AhmedBU21EECE0200026/Capstone-Project-EEE-2025-Empowering-Smart-Grid-for-the-future-of-Urban-Centers/Capstione Project Final/Hardware/Smart Grid/IMG-20250316-WA0008.jpg

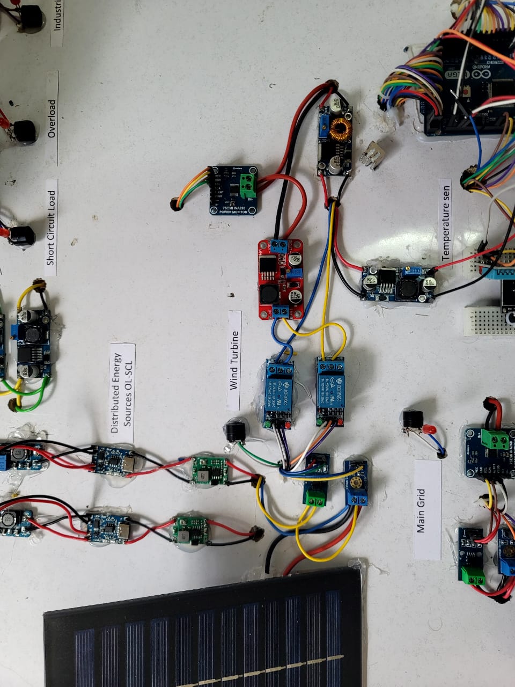
Capstione Project Final/Hardware/Smart Grid/IMG-20250316-WA0008.jpg
