AhmedBU21EECE0200026/Capstone-Project-EEE-2025-Empowering-Smart-Grid-for-the-future-of-Urban-Centers/Capstone Project Introduction/Capston Project poster.pptx

Empowering Smart Grid For The Future Of Urban Centres

Ahmed Abdulrahman Abdullah Bin Alfaqeeh – Seepala Siva Kumar – Yashwanth M

Supervisor : <<Dr. P Sundararaman >>

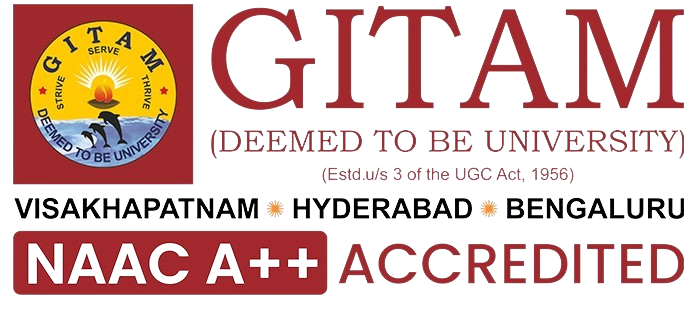
[picture p3: figure]

Abstract

Conclusion

Methods

Results

Background

Future Perspectives

In this project, we successfully designed and integrated a hybrid energy system that includes a solar farm, wind farm, diesel generator, and battery storage system. The solar farm operates based on solar irradiance and temperature data, while the wind farm functions using wind speed data. These energy sources were connected to different types of loads (resistive, capacitive, and inductive), and circuit breakers were incorporated for system protection and control. The project demonstrates efficient energy management by combining renewable sources with a backup generator, ensuring a stable power supply.

In the future, IoT devices will be integrated into the system for enhanced real-time monitoring and remote control. This will enable better supervision, data collection, and optimization of the system's overall performance. The next phase will focus on improving the automation and reliability of the hybrid energy system for real-world applications in urban centers.

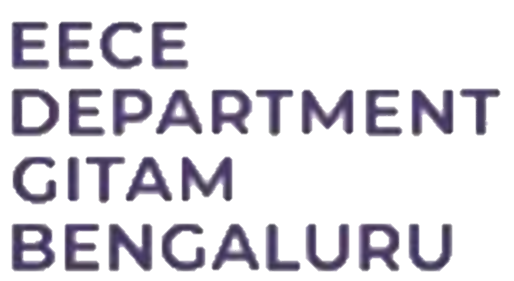
[picture p4: figure]
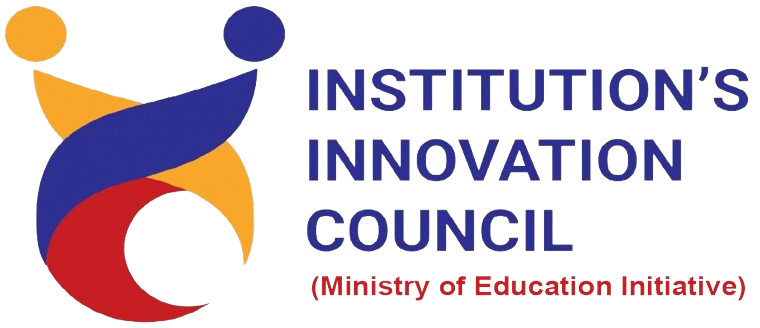
[picture p5: figure]
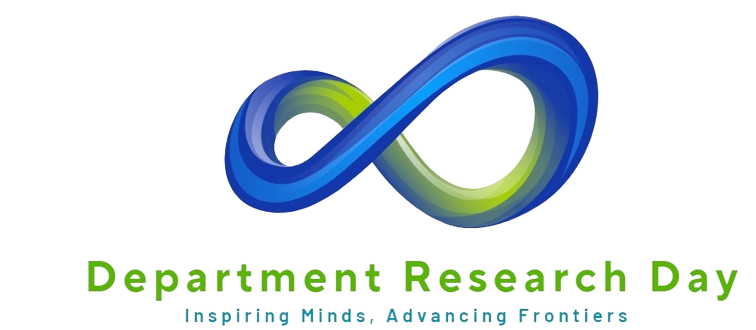
[picture p6: figure]

Insert your text Here

As urban centres continue to grow, the demand for reliable and sustainable energy sources becomes increasingly critical. Our project, "Empowering Smart Grid for the Future of Urban Centres," aims to design and simulate an advanced smart grid system that integrates renewable energy sources—specifically solar and wind power—along with Internet of Things (IoT) devices. The integration of these renewable energy systems into the grid is intended to enhance energy efficiency and reduce carbon emissions, contributing to a cleaner and more sustainable urban environment. Our approach involves the development of a simulation model that incorporates both solar panels and wind turbines, reflecting the diverse energy generation potential in urban settings. By employing IoT devices, we establish a two-way communication network that allows for real-time monitoring and management of energy production, storage, and consumption. This communication infrastructure enables dynamic responses to energy demands, optimization of resource allocation, and improved grid resilience. The project will demonstrate the feasibility and benefits of a smart grid that is not only capable of managing conventional and renewable energy sources but also equipped with control mechanisms. The expected outcomes include enhanced grid reliability, increased integration of clean energy, and the provision of valuable insights for future urban energy planning. This project sets the foundation for smarter, more responsive urban energy systems, paving the way for sustainable growth and energy security in cities.

Insert your text Here

- MATLAB: Used to run codes for uploading data and writing programs for Maximum Power Point Tracking (MPPT) systems.
- Simulink: Used to design and simulate the smart grid model visually.
- Excel: Used to manage and organize data, like temperature, solar irradiance, and wind speed.
- Gantt Chart: Used to track our progress and keep our tasks organized throughout the project.

Insert your text Here

We successfully designed and built a smart grid system that integrates four power sources: a solar farm, wind farm, diesel generator, and battery storage. These sources supply power to four types of loads, including inductive, capacitive, resistive, and mixed loads. Here’s the contribution from each source:
- Solar Farm: 20% of total power.
- Wind Farm: 100% of its capacity.
- Diesel Generator: 20% of total power.
- Battery Storage: 20% of total power.
The solar farm and wind farm can adjust their outputs based on real-time data, allowing the system to be more responsive to actual conditions.
While the combined power met our load demands, we noticed some imbalance in power generation due to the absence of a control system. This is something we plan to address in the next phase

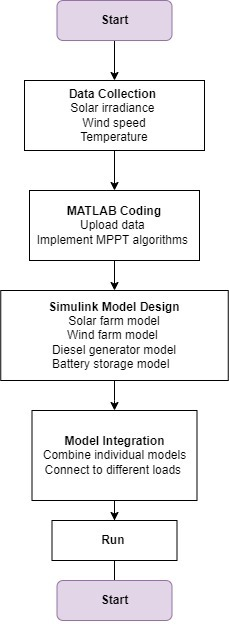
[picture p7: figure]

Insert your text Here

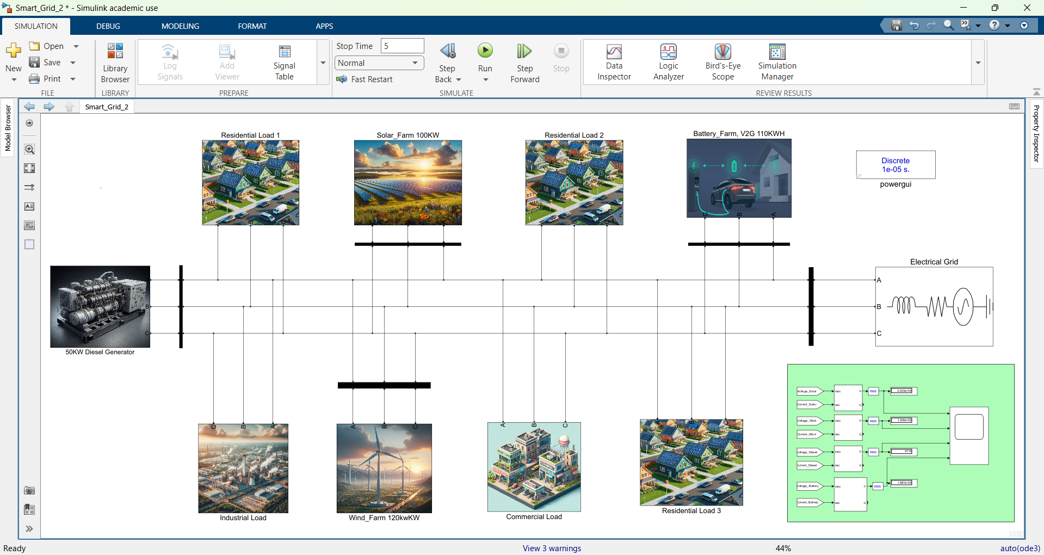
[picture p8: figure]

The increasing global demand for electrical energy, fueled by rapid technological advancements and urbanization, has created significant challenges in power generation, transmission, and distribution. Traditional power grids, which were designed decades ago, are increasingly struggling to meet these demands. The need for enhanced reliability, efficiency, and sustainability in electricity distribution has become more pressing, leading to innovations in grid technology. One such innovation is the development of the "Smart Grid," a modernized electricity network that leverages advanced technologies to improve the efficiency and reliability of power distribution systems. The Smart Grid integrates digital communication, automation, and control technologies to create a more resilient and adaptable power infrastructure. In parallel, Microgrids have gained attention as a localized solution to energy challenges, particularly in regions where power supply is unreliable. Microgrids provide higher energy security and reliability by integrating distributed energy resources, including renewable sources like solar and wind. However, despite their potential, the adoption of Microgrids is often limited by their complexity and the high costs associated with their design and implementation. Additionally, the optimization of smart grid systems is becoming increasingly important, particularly through the integration of hybrid energy systems such as photovoltaic (PV) arrays and wind turbines (WT). The use of advanced algorithms, such as Maximum Power Point Tracking (MPPT), has shown promise in maximizing power generation and improving the overall efficiency of these systems. In urban environments, the integration of renewable energy, particularly solar power, presents unique challenges. Limited space and shading are significant obstacles to deploying solar panels in densely populated areas. However, advancements in photovoltaic technologies, energy storage solutions, and smart city concepts—utilizing IoT is paving the way for more efficient monitoring, control, and integration of solar power in urban settings. This evolving landscape highlights the need for innovative approaches and advanced technologies to address the growing energy challenges of the modern world. The transition to Smart Grids and the development of Microgrids are critical steps in ensuring a more reliable, efficient, and sustainable global energy infrastructure, particularly as urbanization continues to accelerate.

Insert your text Here

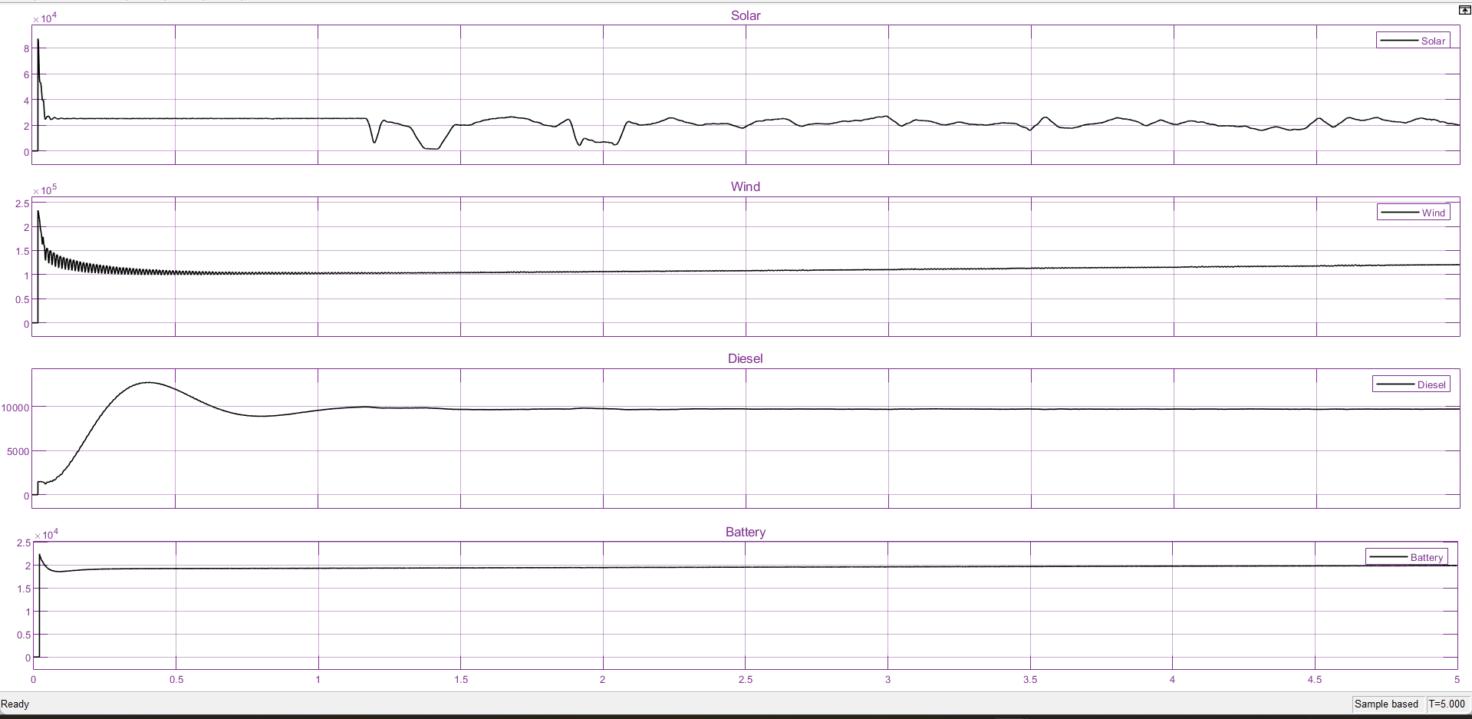
[picture p9: figure]
