AhmedBU21EECE0200026/Capstone-Project-EEE-2025-Empowering-Smart-Grid-for-the-future-of-Urban-Centers/Capstione Project Final/Hardware/Wind turbine/Calculation for windturbine.pdf

Theoretical Calculations for the Wind Turbine

The wind turbine design is based on real-time wind speed data collection and theoretical calculations. Key considerations include:

Given:
1. Type of Wind Turbine: Vertical Axis Wind Turbine (VAWT) H Rotor Type
2. Main supporting Column:
a. Diameter: | 60 mm
b. Length: | 1.2 m
3. Rotor Shaft:
a. Diameter: | 25 mm
b. Length: | 30 cm
4. Rotor Diameter: | 80 cm
5. Blades:
a. NO. | 6
b. Height: | 60 cm
c. Semi-circle of area A ≈ 91.1cm²
6. Wind Speed: | 3.9 m/s
1) Tip Speed Ratio (TSR):
3.5 (Chosen for typical efficiency in VAWT systems, considering blade characteristics and rotor design.)

2)Calculate RPM:
The formula to calculate RPM (Revolutions Per Minute) is: RPM = (V_rotor * 60) / (π * D_rotor)
- Where:
- V_rotor = Rotor speed in m/s (calculated earlier as 9.74 m/s)
- D_rotor = Rotor diameter in meters (80 cm)
Substituting the values:
RPM = (9.74 * 60) / (π * 1.03) RPM = 232.52
Calculated RPM: 232.52

3)Calculate Angular Velocity:
The formula to calculate angular velocity (ω) is: ω = (2 * π * RPM) / 60
- Where:
- RPM = Rotational speed in revolutions per minute (calculated as 180.7)
Substituting the values:
ω = (2 * π * 232.52) / 60
ω ≈ 24.35 rad/s
Calculated Angular Velocity: 24.35 rad/s 4)Calculate Power:
The formula to calculate power (P) is:
P = 0.5 * ρ * A * v_wind^3 * Cp
- Where:
- ρ = Air density (1.225 kg/m³ at sea level)
- A = Swept area of the turbine (π * (D_rotor / 2)²
)
- V_wind = Wind speed (3.9 m/s)
- Cp = Power coefficient (typically 0.35 for VAWTs) Substituting the values:
A = π * (0.8 / 2)² ≈ 0.5m²
P = 0.5 * 1.225 * 0.5 * (3.9)³ * 0.35 P ≈ 10.33 W
Calculated Power: 6.51 W

5)Calculate Torque:
The formula to calculate torque (T) is: T = P / ω
- Where:
- P = Power in watts (calculated as 6.51 W)
- ω = Angular velocity in rad/s (calculated as 24.35 rad/s) Substituting the values:
T = 10.33 / 24.35
T ≈ 0.547 N·m
Calculated Torque: 0.424 N·m

Wind turbine Block Diagram

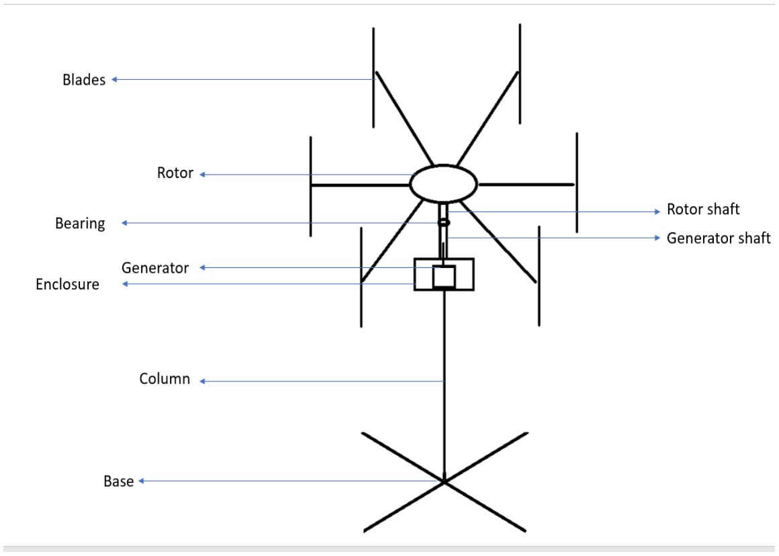
[picture p43: figure]
