AhmedBU21EECE0200026/Capstone-Project-EEE-2025-Empowering-Smart-Grid-for-the-future-of-Urban-Centers/Capstione Project Final/Code/Flow Chart Smart Grid.jpeg

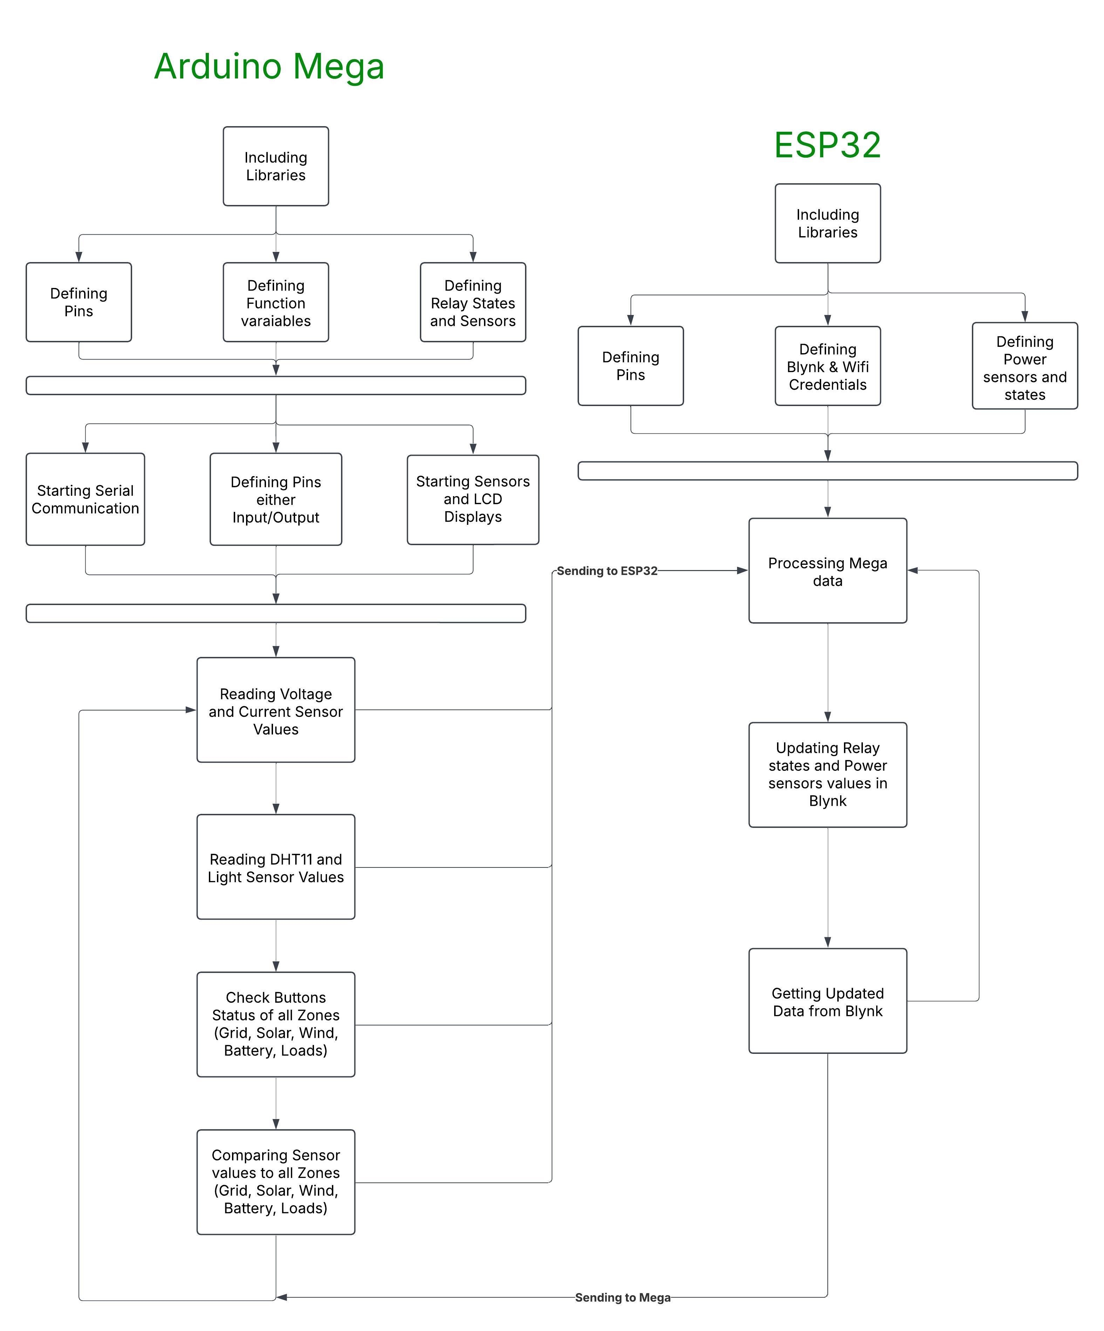
Capstione Project Final/Code/Flow Chart Smart Grid.jpeg
