AhmedBU21EECE0200026/Capstone-Project-EEE-2025-Empowering-Smart-Grid-for-the-future-of-Urban-Centers/Capstione Project Final/Hardware/Smart Grid/Fuul integration.jpg

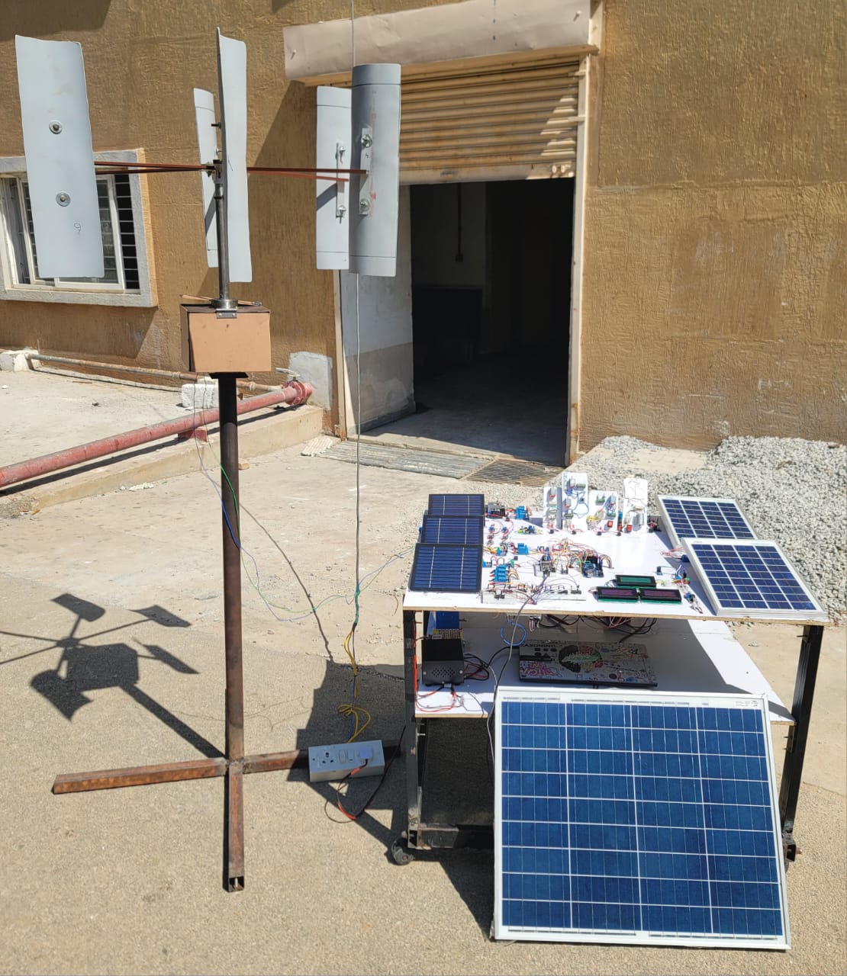
Capstione Project Final/Hardware/Smart Grid/Fuul integration.jpg
