AhmedBU21EECE0200026/Capstone-Project-EEE-2025-Empowering-Smart-Grid-for-the-future-of-Urban-Centers/Capstone Project Introduction/Simulation/Reference Simulations/Microgrid Hybrid PV_ Wind _ Battery Management System/resources/previewImage.png

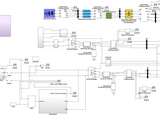
Capstone Project Introduction/Simulation/Reference Simulations/Microgrid Hybrid PV_ Wind _ Battery Management System/resources/previewImage.png
