AhmedBU21EECE0200026/Capstone-Project-EEE-2025-Empowering-Smart-Grid-for-the-future-of-Urban-Centers/Capstone Project Introduction/Simulation/Reference Simulations/power_V2G.slx (Unzipped Files)-20240822T073907Z-001/power_V2G.slx (Unzipped Files)/metadata/thumbnail.png

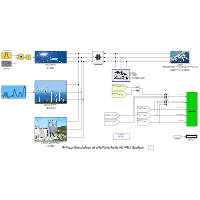
Capstone Project Introduction/Simulation/Reference Simulations/power_V2G.slx (Unzipped Files)-20240822T073907Z-001/power_V2G.slx (Unzipped Files)/metadata/thumbnail.png
