AhmedBU21EECE0200026/Capstone-Project-EEE-2025-Empowering-Smart-Grid-for-the-future-of-Urban-Centers/Capstione Project Final/Hardware/Wind turbine/Wind turbine design VAWT.step

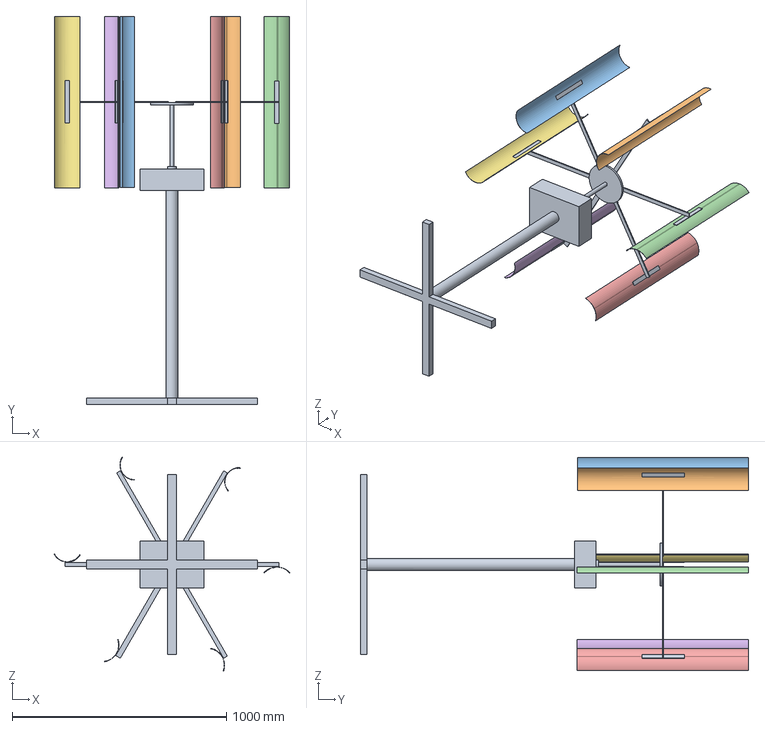
[picture p65: CAD file, 2025-03-16]
Capstione Project Final/Hardware/Wind turbine/Wind turbine design VAWT.step
1099.9 x 1813.0 x 997.2 mm
