AhmedBU21EECE0200026/Capstone-Project-EEE-2025-Empowering-Smart-Grid-for-the-future-of-Urban-Centers/(commit log)

2025-03-16 all added
    [Data Set for Smart Grid.csv, Irradiance.xlsx, New Data.csv, Temp.xlsx, Wind turbine design VAWT.step, t_s_d.xlsx, w_s_d.xlsx]
2025-03-17 Update README.md
    Sample for link
